Kylin233333/Mechanical_DesignCourse_DesignSpecification/document/bibliography.tex

% !TeX root = ../HebutThesis_example.tex(此文件是被HebutThesis_example.tex调用的)
% 正常情况下，此文件不需要使用者改动

\nocite{*} % 引用所有参考文献
\printbibliography[title=参考文献,heading=bibintoc]
