Kylin233333/Mechanical_DesignCourse_DesignSpecification/document/chap08.tex

\chapter{键联接的选择及校核计算}
\section{高速轴键选择及校核}
\subsection{联轴器键连接计算校核}
选择的型号为A型键$b\times h \times L = 8\times 7\times 80$\\
键的工作长度$l=L-b=80-8=72mm$\\
联轴器材料为铸铁，载荷平稳取$[p] = 120 \text{ MPa}$，
则其挤压强度为：
\begin{equation}
    \sigma_p = \frac{4000T}{hld} = \frac{4000\times 35.75}{7\times 72\times 15}
    = 18.91 \text{ MPa}
\end{equation} 
$\sigma_p < [p]$，故满足强度要求

\section{中间轴键选择及校核}
\subsection{高速级大齿轮键连接计算校核}
选择的型号为双A型键$b\times h \times L = 10\times 8\times 36$，双键相隔$180^\circ$布置。\\
键的工作长度$l=1.5\times (L-b)=1.5\times(32-10)=33mm$\\
齿轮材料为40Cr，载荷平稳取$[\sigma_p] = 150 \text{ MPa}$，
则其挤压强度为：
\begin{equation}
    \sigma_p = \frac{4000T}{hld} = \frac{4000\times 163.10}{8\times 33\times 17.5}
    = 141.21 \text{ MPa}
\end{equation} 
$\sigma_p < [p]$，故满足强度要求
\subsection{低速级小齿轮键连接计算校核}
选择的型号为A型键$b\times h \times L = 10\times 8\times 63$\\
键的工作长度$l=L-b=63-10=53mm$\\
齿轮材料为40Cr，载荷平稳取$[\sigma_p] = 150 \text{ MPa}$，
则其挤压强度为：
\begin{equation}
    \sigma_p = \frac{4000T}{hld} =\frac{4000\times 163.10}{8\times 53\times 17.5}= 87.92 \text{ MPa}
\end{equation} 
$\sigma_p < [p]$，故满足强度要求

\section{低速轴键选择及校核}
\subsection{低速级大齿轮键连接计算校核}
选择的型号为A型键$b\times h \times L = 18\times 11\times 63$\\
键的工作长度$l=L-b=63-18=45mm$\\
齿轮材料为40Cr，载荷平稳取$[\sigma_p] = 150 \text{ MPa}$，
则其挤压强度为：
\begin{equation}
    \sigma_p = \frac{4000T}{hld} = \frac{4000\times 531.35}{11\times 45\times 32.5}=132.11 \text{ MPa}
\end{equation} 
$\sigma_p < [p]$，故满足强度要求
\subsection{联轴器键连接计算校核}
选择的型号为A型键$b\times h \times L = 14\times 9\times 110$\\
键的工作长度$l=L-b=110-14=96mm$\\
联轴器材料为铸铁，载荷平稳取$[p] = 120 \text{ MPa}$，
则其挤压强度为：
\begin{equation}
    \sigma_p = \frac{4000T}{hld} = \frac{4000\times 531.35}{9\times 96\times 22.5}
    = 109.33 \text{ MPa}
\end{equation} 
$\sigma_p < [p]$，故满足强度要求
