Kylin233333/Mechanical_DesignCourse_DesignSpecification/HebutThesis_example.tex

\documentclass[design]{hebutthesis}
\begin{document}

\pdfbookmark[section]{论文标题}{cover}  %在生成的PDF文档中创建书签
\input{document/cover}      %插入封面
\pdfbookmark[section]{\contentsname}{contents}  
\tableofcontents            %自动生成目录

\newpage
\setcounter{page}{1}        % 将当前页面的页码计数器设置为1
\pagenumbering{arabic}      % 将页面编号设置为阿拉伯数字形式

% 正文部分
\input{document/chap01}     
\input{document/chap02}
\input{document/chap03}
\input{document/chap04}
\input{document/chap05}
\input{document/chap06}
\input{document/chap07}
\input{document/chap08}
\input{document/chap09}
\input{document/chap10}
\input{document/chap11}

%其他
\input{document/bibliography}           %插入参考文献,用的第三方包包括此包，所以不用手动添加到目录

\end{document}
