Kylin233333/Mechanical_DesignCourse_DesignSpecification/document/cover.tex

% !TeX root = ../HebutThesis_example.tex(此文件是被HebutThesis_example.tex调用的)
% 在此文件中编辑您论文封面里需要填写的内容
\setyear{2025}              % 设置年份
\titleone{带式运输机传动装置}
\titletwo{带式运输机传动装置}
\deletetitletwo{1}          % 如果不需要第二行，请把0换为1
\author{wdnmd}
\studentID{114514}
\class{机设515}
\major{机械设计制造及其自动化}
\supervisor{教师号 \qquad 姓名 \qquad 职称}
\reviewer{姓名 \qquad 职称}
\hebutThesisTime{2025年12月}              
\maketitle
