Kylin233333/Mechanical_DesignCourse_DesignSpecification/figures/定位销.pdf

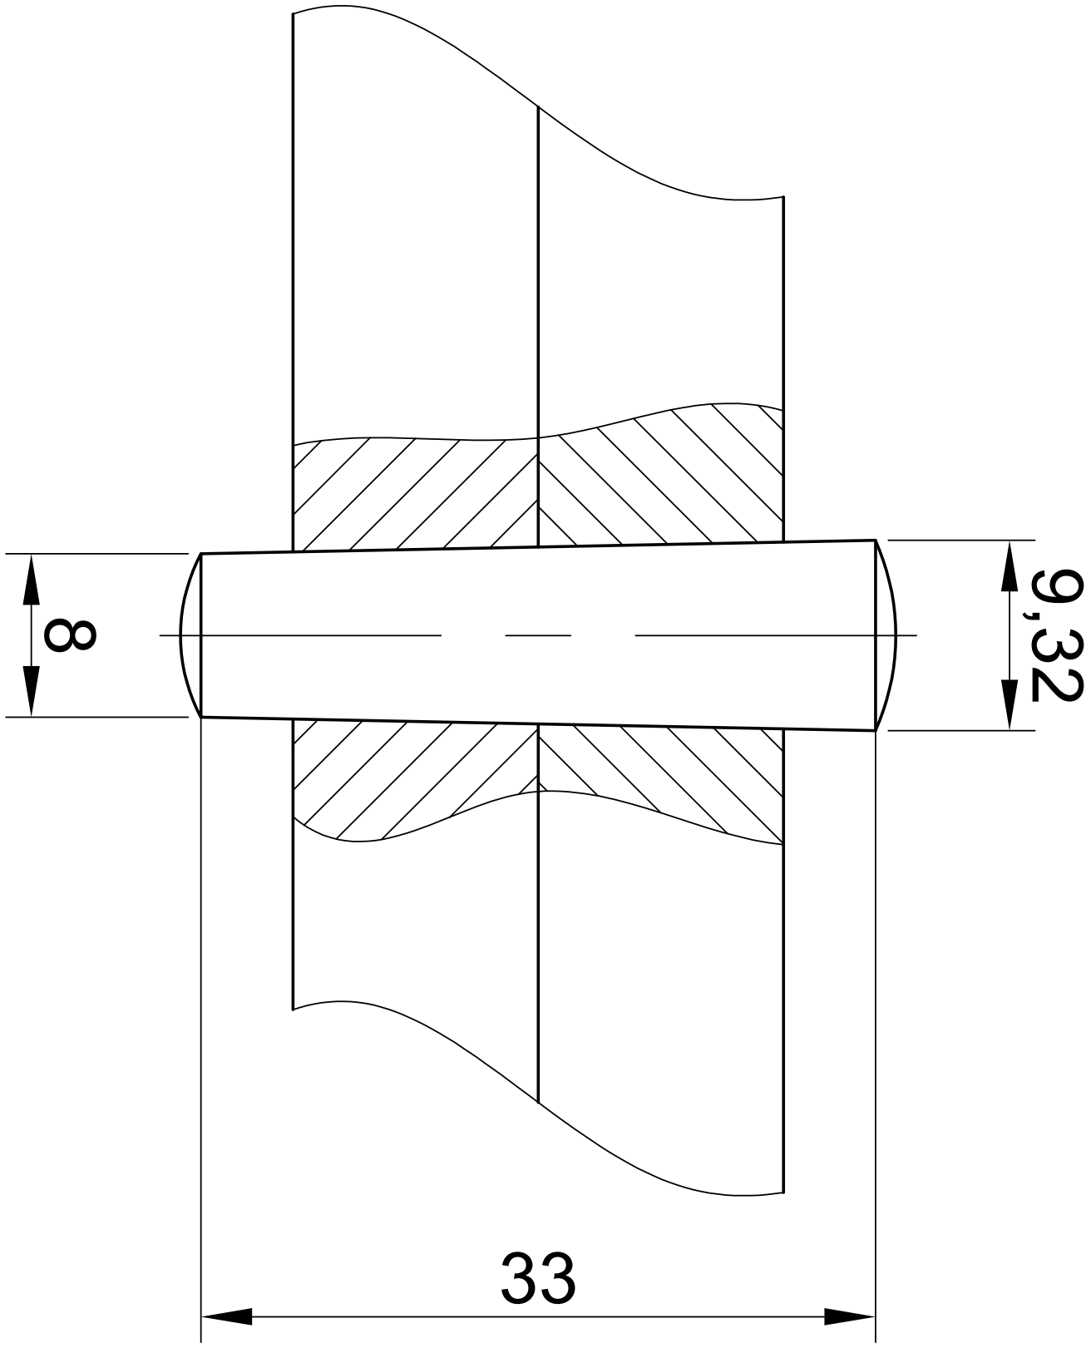
[picture p1: figure]
