Kylin233333/Mechanical_DesignCourse_DesignSpecification/figures/1.png

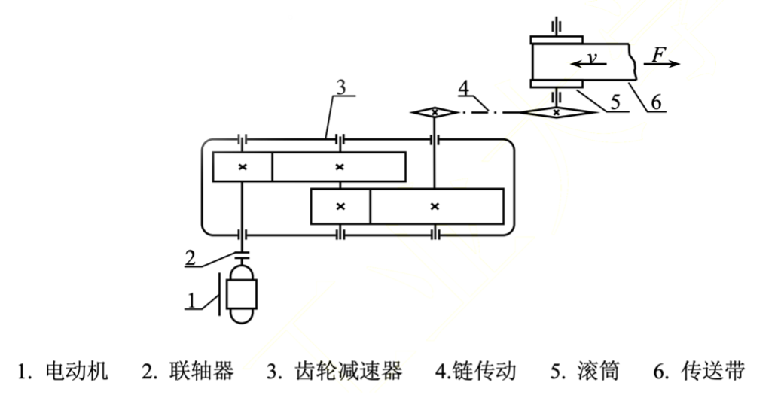
figures/1.png
