Kylin233333/Mechanical_DesignCourse_DesignSpecification/figures/dianji.png

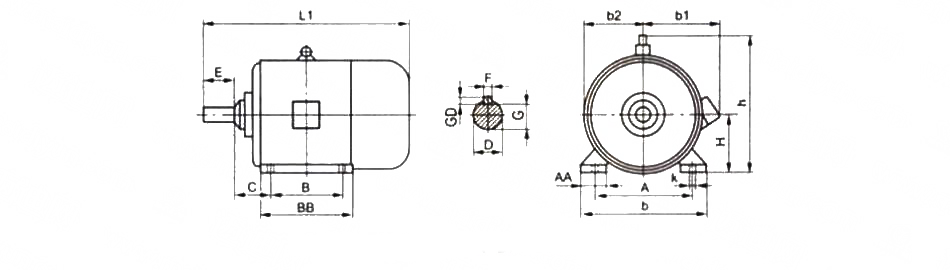
figures/dianji.png
