Kylin233333/Mechanical_DesignCourse_DesignSpecification/figures/吊环.png

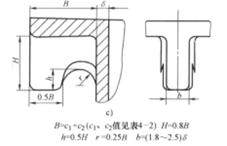
figures/吊环.png
