Kylin233333/Mechanical_DesignCourse_DesignSpecification/figures/吊耳.png

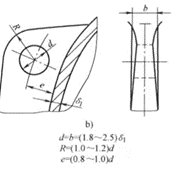
figures/吊耳.png
