Kylin233333/Mechanical_DesignCourse_DesignSpecification/figures/聊天图片_20251218105615.jpg

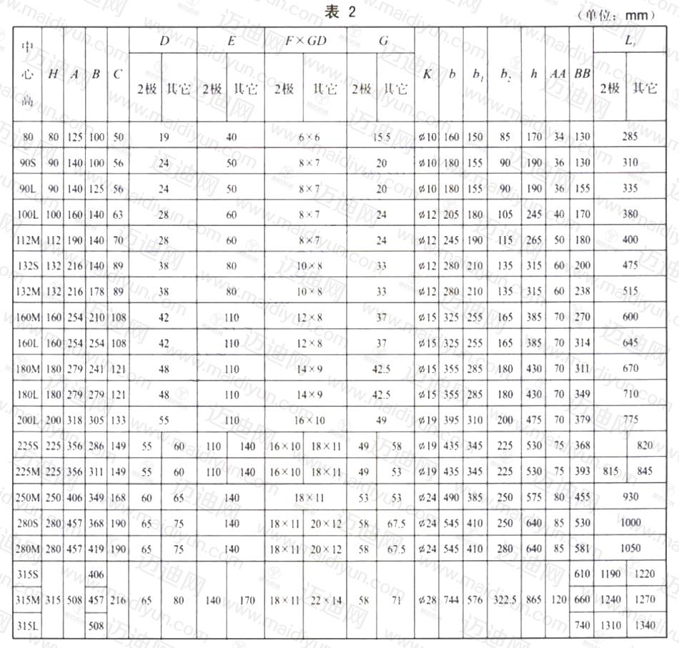
figures/聊天图片_20251218105615.jpg
