Kylin233333/Mechanical_DesignCourse_DesignSpecification/(list of files, cad)

Other CAD files:
dwg/final.dwg
dwg/输出轴.dwg
dwg/输出齿轮.dwg
