Kylin233333/Mechanical_DesignCourse_DesignSpecification/figures/放气.pdf

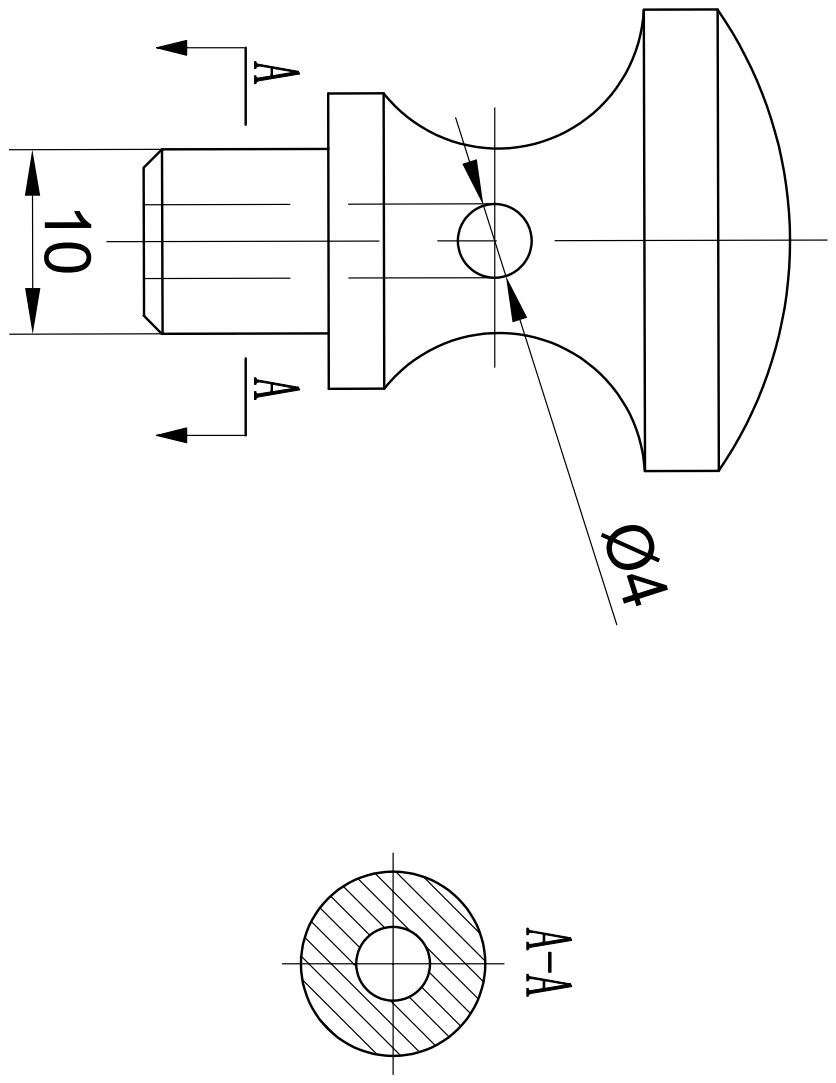
[picture p7: page 1]
