Kylin233333/Mechanical_DesignCourse_DesignSpecification/figures/放油.pdf

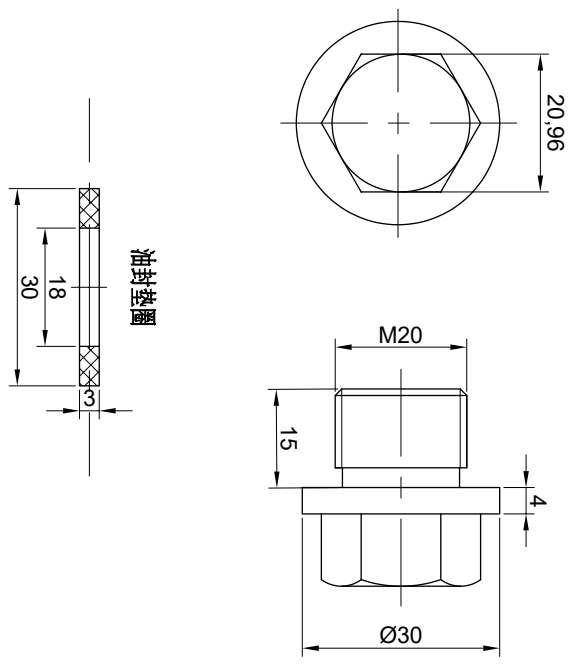
[picture p8: page 1]
