Kylin233333/Mechanical_DesignCourse_DesignSpecification/figures/油标.pdf

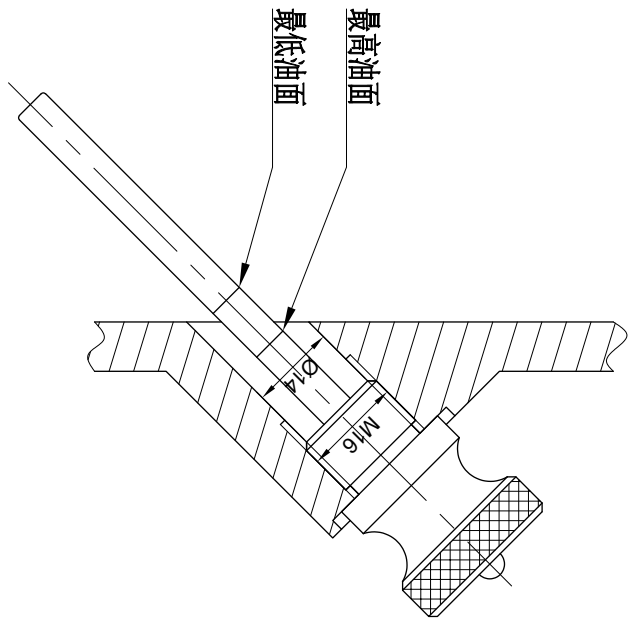
[picture p9: page 1]
