Kylin233333/Mechanical_DesignCourse_DesignSpecification/figures/起盖.pdf

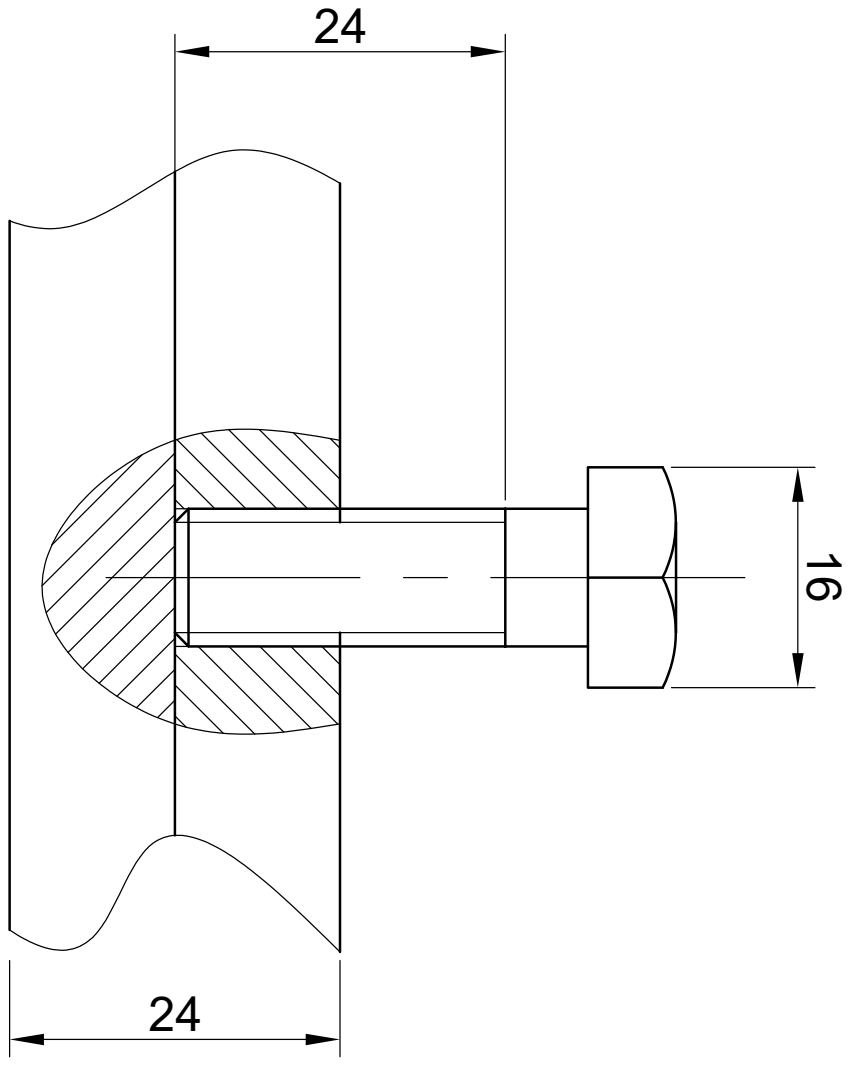
[picture p10: page 1]
