Kylin233333/Mechanical_DesignCourse_DesignSpecification/figures/顶盖.pdf

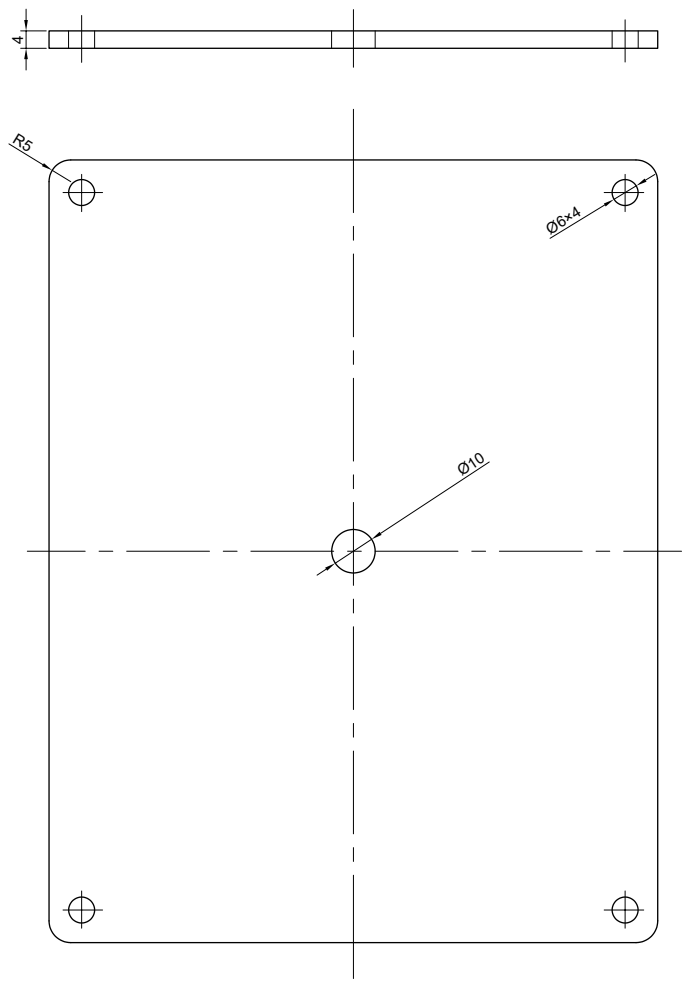
[picture p11: page 1]
