Kylin233333/Mechanical_DesignCourse_DesignSpecification/figures/3弯扭.pdf

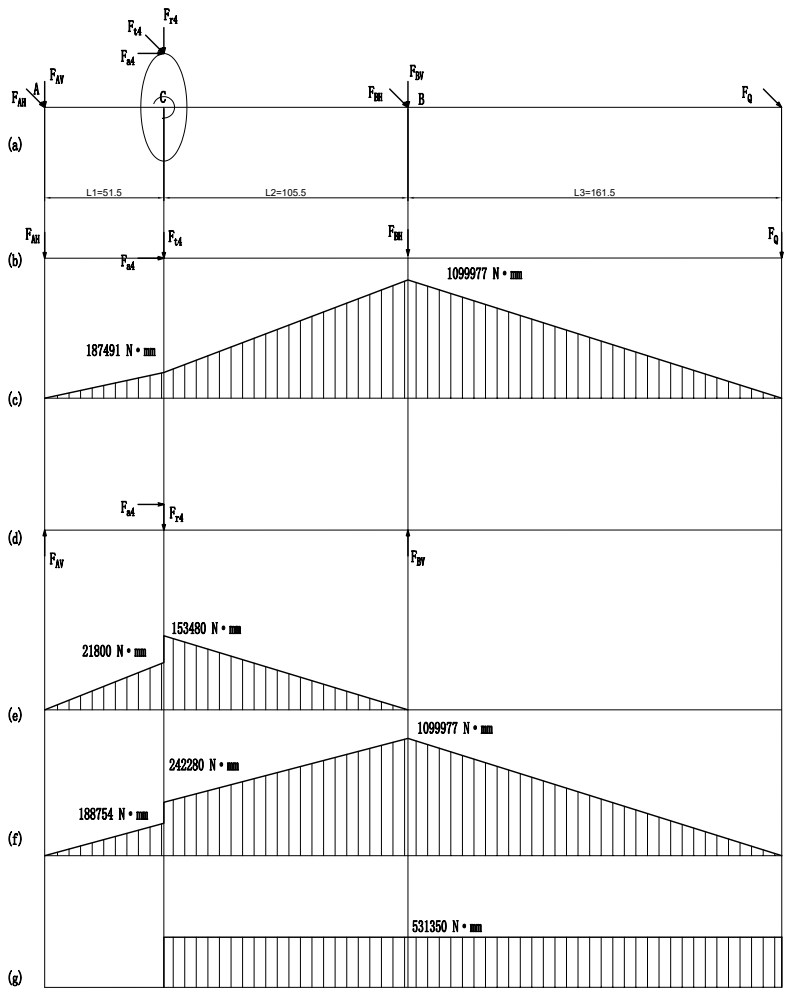
[picture p12: page 1]
