Kylin233333/Mechanical_DesignCourse_DesignSpecification/figures/1弯扭.pdf

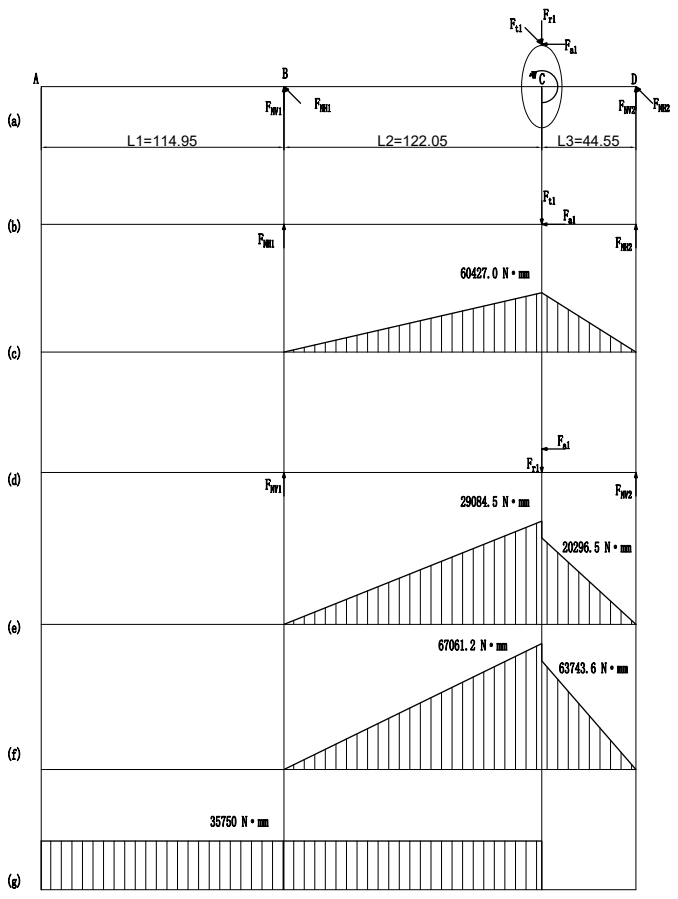
[picture p13: page 1]
