Kylin233333/Mechanical_DesignCourse_DesignSpecification/figures/1轴.pdf

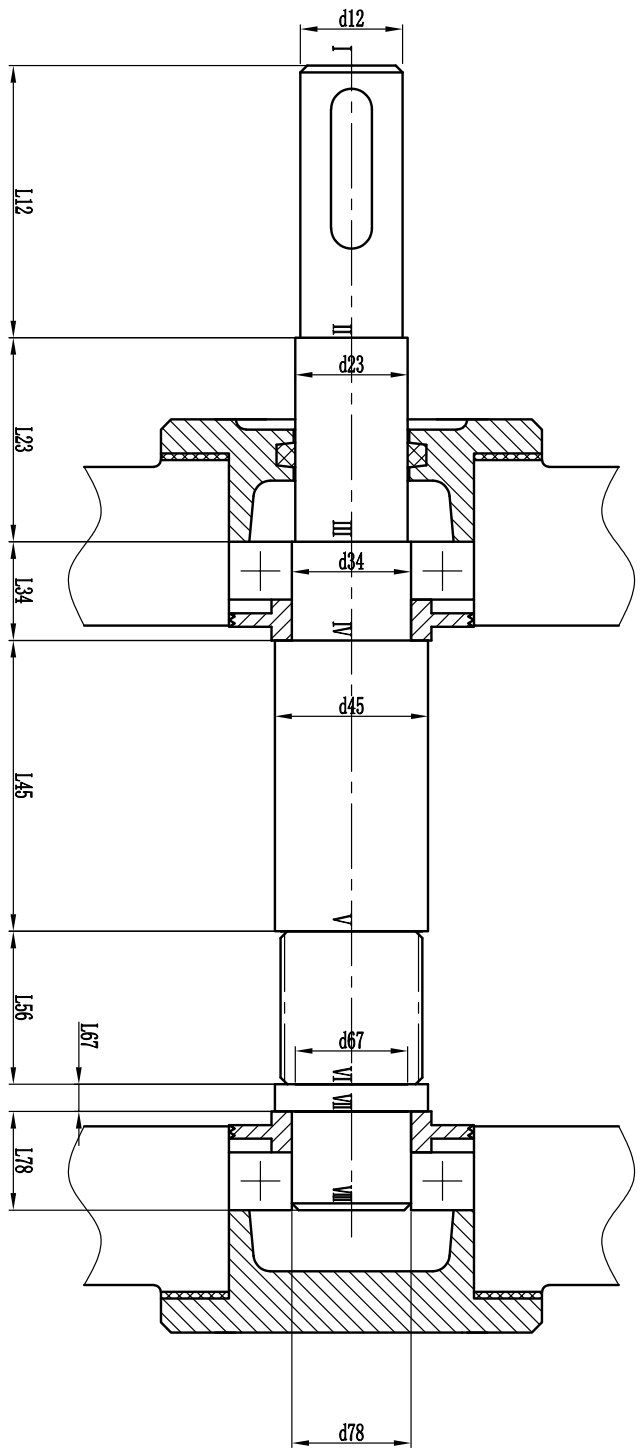
[picture p14: page 1]
