Kylin233333/Mechanical_DesignCourse_DesignSpecification/figures/2弯扭.pdf

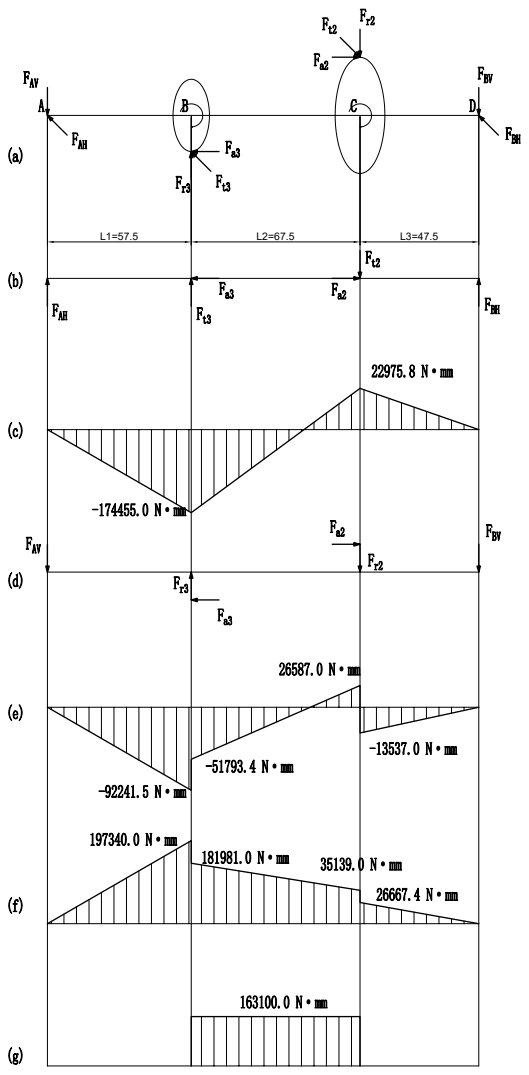
[picture p15: page 1]
