Kylin233333/Mechanical_DesignCourse_DesignSpecification/figures/2轴.pdf

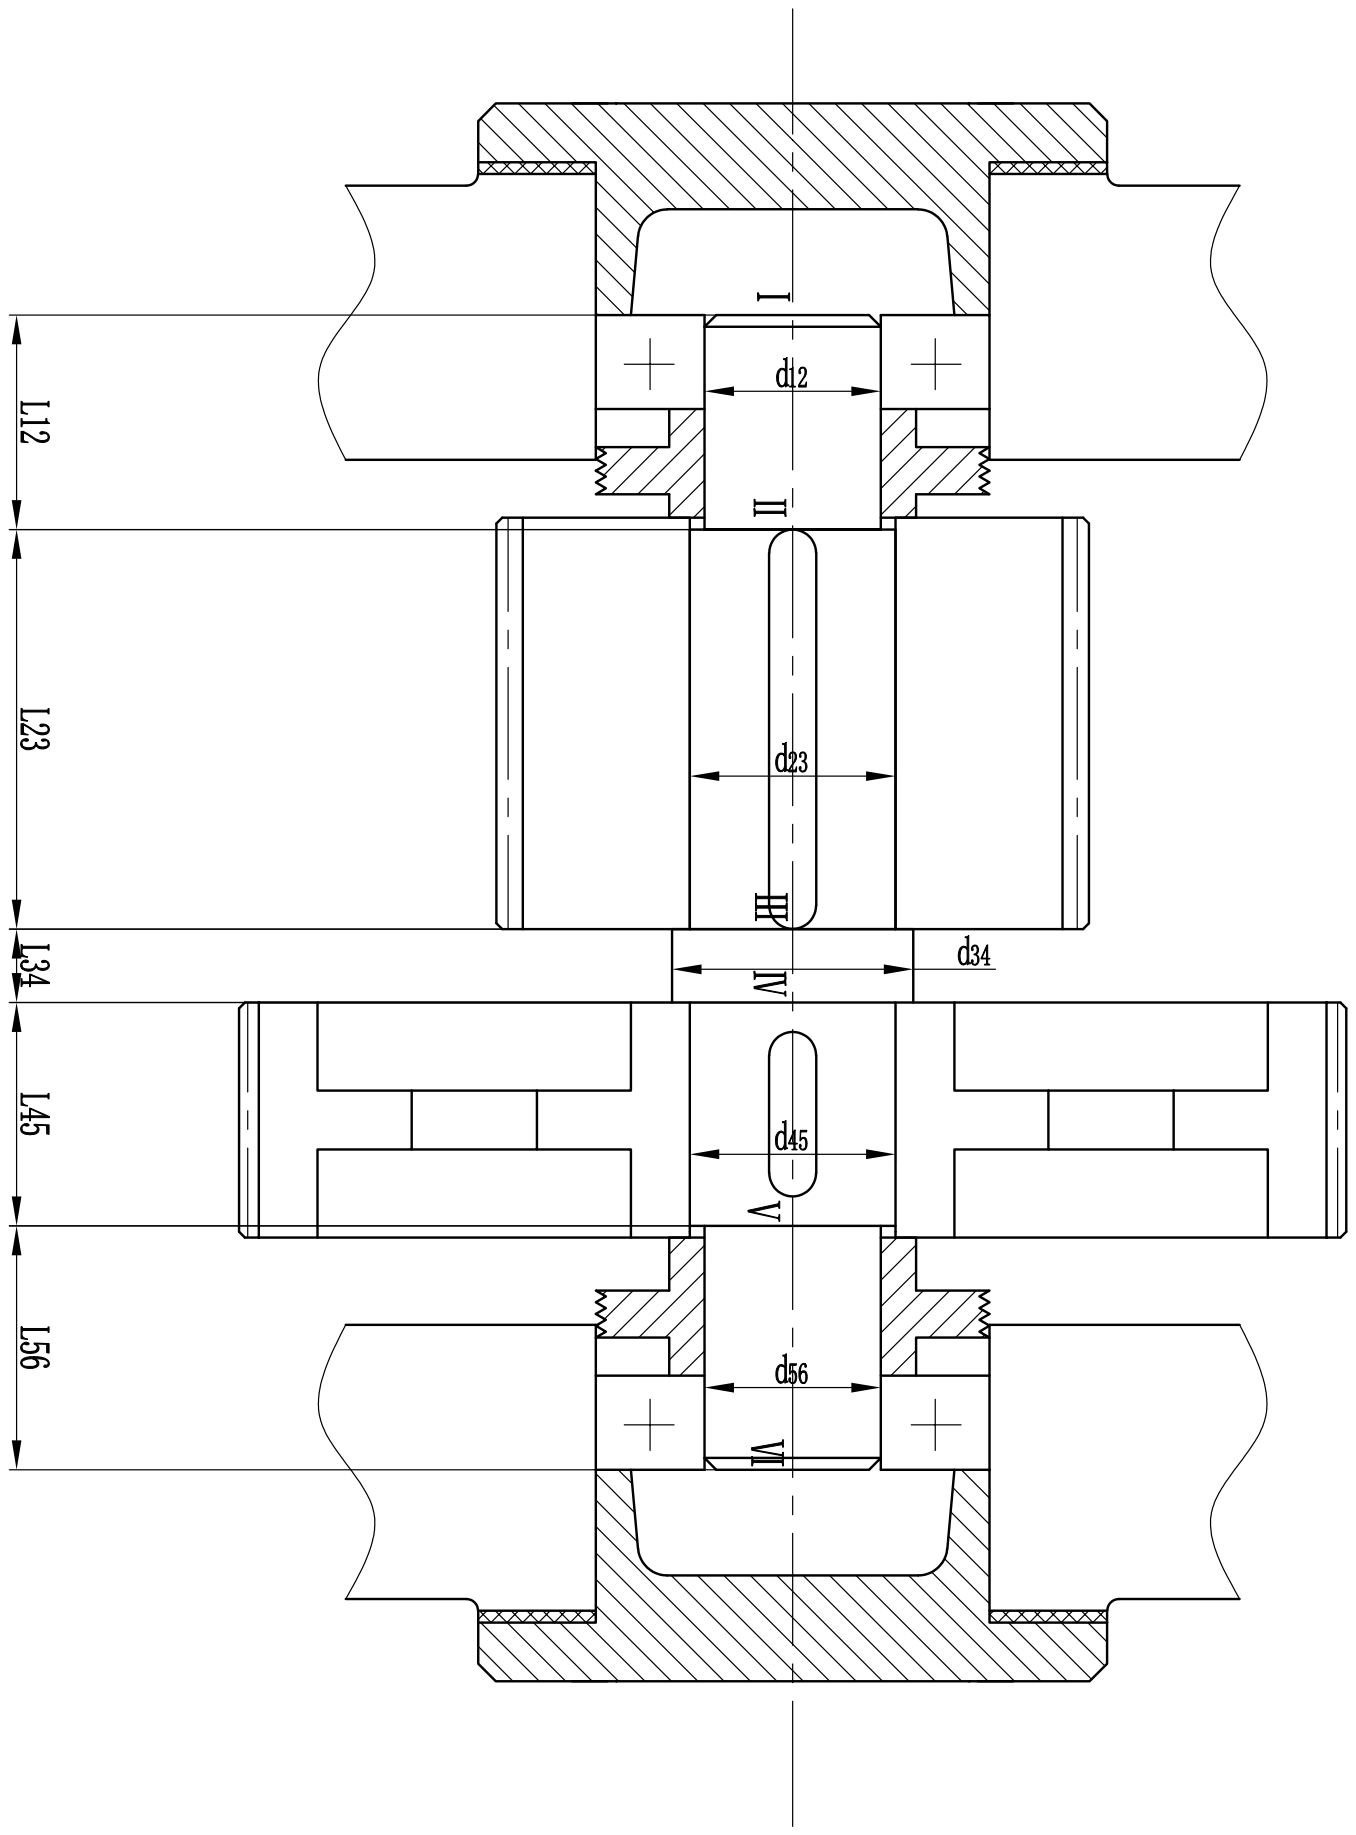
[picture p16: page 1]
