Kylin233333/Mechanical_DesignCourse_DesignSpecification/figures/3轴.pdf

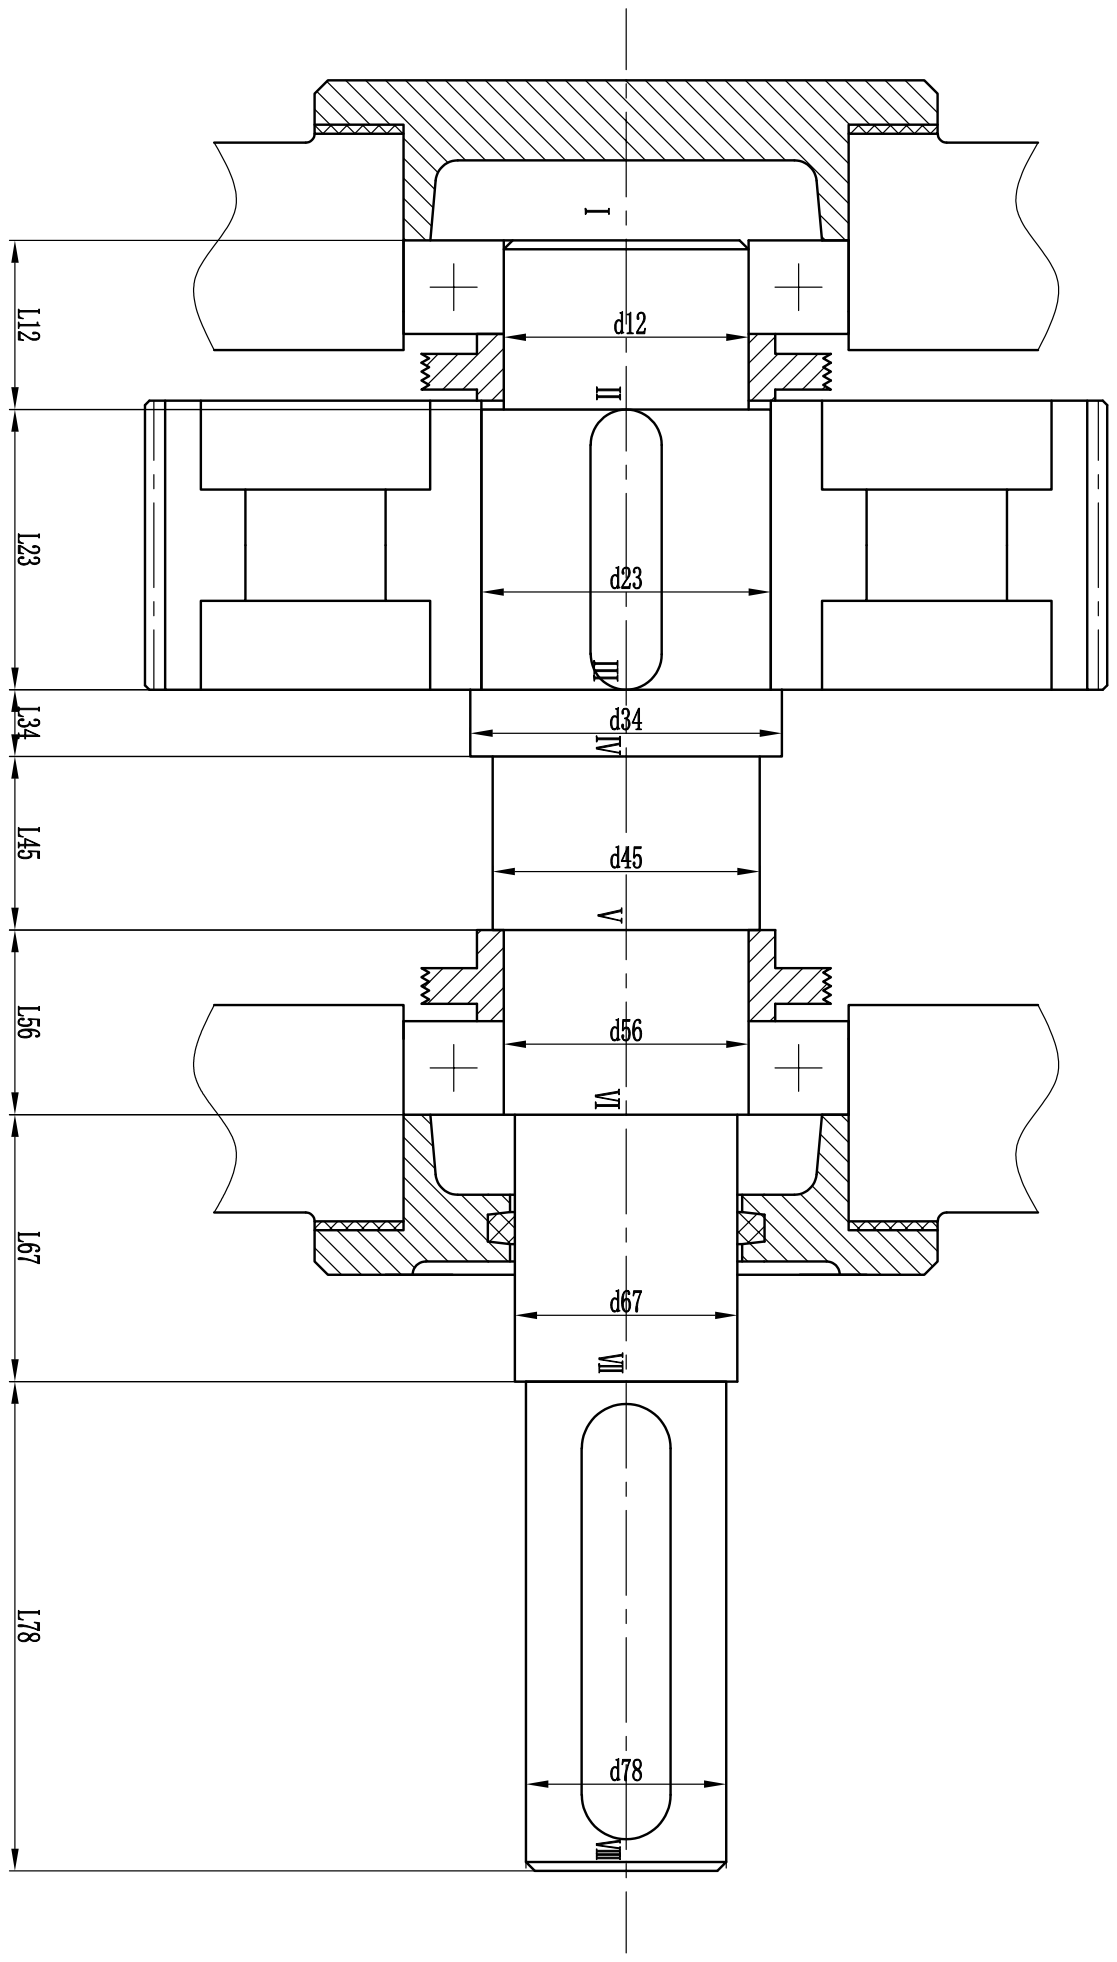
[picture p17: page 1]
