Kylin233333/Mechanical_DesignCourse_DesignSpecification/(commit log)

2025-12-18 轴系完成
2025-12-18 轴系小修改
2025-12-18 轴系修改＆传动部分
2025-12-18 传动计算完成
2025-12-19 轴承校核完成
2025-12-19 键校核计算完成
2025-12-19 键计算修改
2025-12-19 bug修复
2025-12-19 改bug
2025-12-20 大改键槽。。。
2025-12-20 键槽-final
2025-12-21 联轴器完成&改标题
2025-12-21 密封-润滑完成
2025-12-21 箱体尺寸完成
2025-12-21 机体结构尺寸表
2025-12-22 同步一下
2025-12-22 机体附件-text
2025-12-22 附件&机体结构完成
2025-12-25 dwg线形&标注小改
    [final.dwg, 输出轴.dwg, 输出齿轮.dwg]
2025-12-26 dwg细节修改
    [final.dwg, 输出轴.dwg, 输出齿轮.dwg]
2025-12-29 完善参考文献&传动比分配
2025-12-29 dwg小改
    [final.dwg, 输出轴.dwg, 输出齿轮.dwg]
2026-06-22 清理 LaTeX 中间文件，添加 .gitignore，重写 README
    - 删除 .aux .bbl .bcf .blg .log .run.xml .synctex.gz .toc 等编译中间文件
    - 删除所有 .DS_Store 及 out/ 目录
    - 添加 .gitignore 防止以后提交中间文件
    - 重写 README.md
2026-08-04 完善LICENSE
